Connaxio/kicad-library/README.md

# connaxio-kicad-library

How to use this library
1. Clone this repository;
2. Add "CONNAXIO_KICAD_LIB_DIR" as a new 3D search path that points to the repository folder;
3. Enjoy!
