Connaxio/kicad-library/(commit log)

2021-12-02 Create resistors, caps, pmos, pnp parts
2021-12-05 Add PoE transformer and connectors and reg flyback
2021-12-05 Change naming convention and add RJ45 POE+ footprint and 3d model
2021-12-07 Completed initial creation of footprints for Espoir. Bugfixes incoming.
2021-12-10 Added diodes, header 1x15, resistors, etc.
2021-12-10 Add NPTH MTH and 25V cap for 12V output and 6V TVS
2021-12-11 Changed PoE connector pin types
2022-01-05 migrate to KiCad 6.0
2022-03-15 Updated Through-hole properties of footprints
2022-04-03 Fix paste mask expansion, add test point, start adding .step 3d models as per KiCad standard
2022-04-24 Remove solder mask holes under flat packs ot improve emissivity
2022-05-05 Add 100 mils headers and mikroBUS socket
2022-05-12 Add step files for all footprints
2022-05-30 Add resistors and fix connectors for PnP
2022-12-06 Add Si34061 and 0805 resistor package
2023-01-19 Add TP 1mm, SOT-223, Barrel jack, terminal block
2023-01-20 Add other H bridge driver and NMOS
2023-01-23 Add IO expanders, add motor controller socket
2023-01-23 Add parts (I2c buffer, resistors, PTC, current sensor, adc)
2023-01-24 Fix connaixo mtor driver board footprint add mini blade fuse
2023-01-31 Fix Current sensor footprint, add M5 mounting hole (NPTH)
2023-03-01 Add slot Fix NMOS pads due to fucking bad datasheet
2023-03-05 Add 555 timer and SOIC8 Add 2x8 SMD connector 100 mils
2023-03-06 Fix PTC parameters Add TMP1075 sensor
